PhamVietDan/Micromouse-Maze-solving-robot/wheelsV2.STL

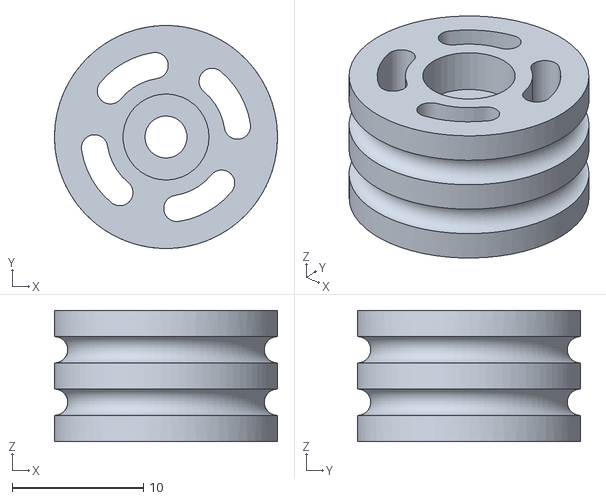
[picture p33: CAD file, 2026-02-28]
wheelsV2.STL
17.0 x 17.0 x 10.0
