PhamVietDan/Micromouse-Maze-solving-robot/GASV1.STL

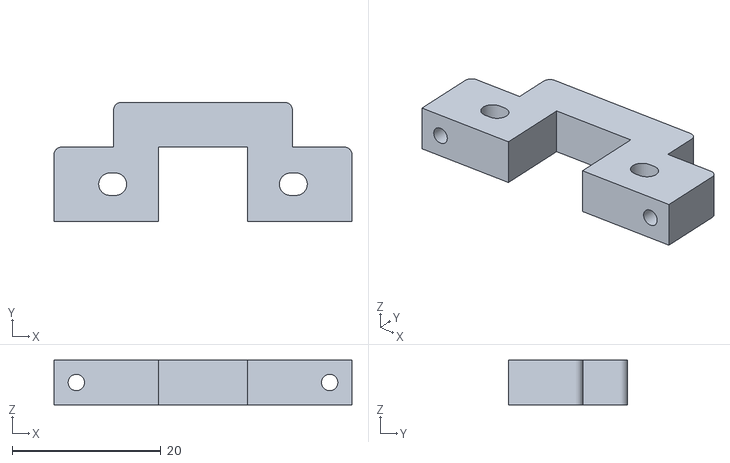
[picture p34: CAD file, 2026-02-28]
GASV1.STL
40.0 x 16.0 x 6.00
