PhamVietDan/Micromouse-Maze-solving-robot/GASV2.STL

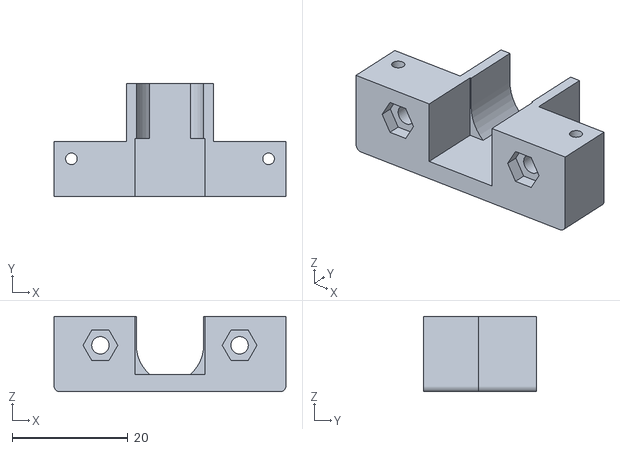
[picture p35: CAD file, 2026-02-28]
GASV2.STL
40.0 x 19.5 x 13.0
