PhamVietDan/Micromouse-Maze-solving-robot/wheelsV1.STL

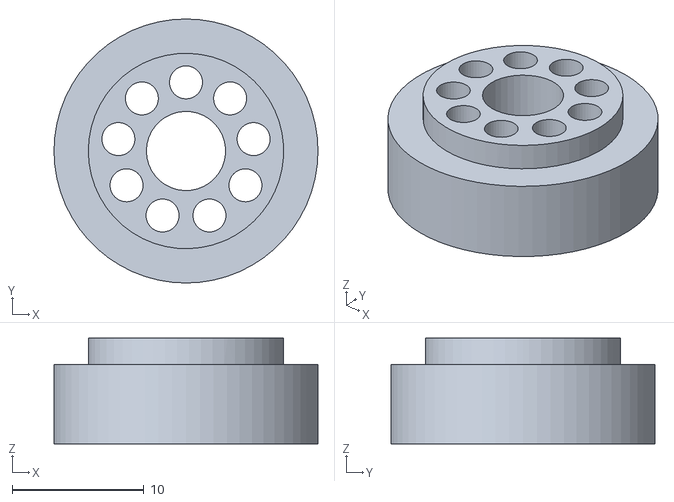
[picture p36: CAD file, 2026-02-28, an earlier design]
wheelsV1.STL
20.0 x 20.0 x 8.00
