PhamVietDan/Micromouse-Maze-solving-robot/Sơ đồ chính_3sodochinh.pdf

# Micromouse

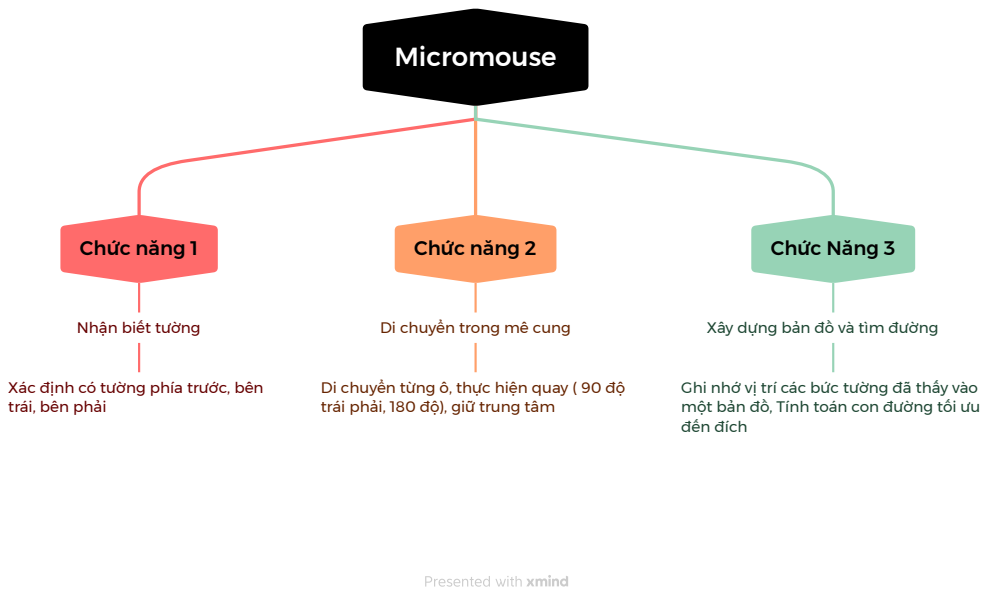
[picture p37: page 1]
Chức năng 1; Chức năng 2; Chức Năng 3

Nhận biết tường

Di chuyển trong mê cung

Xây dựng bản đồ và tìm đường

Xác định có tường phía trước, bên
trái, bên phải

Di chuyển từng ô, thực hiện quay ( 90 độ
trái phải, 180 độ), giữ trung tâm

Ghi nhớ vị trí các bức tường đã thấy vào
một bản đồ, Tính toán con đường tối ưu
đến đích

# Tích hợp phần cứng

## IR trước (1)

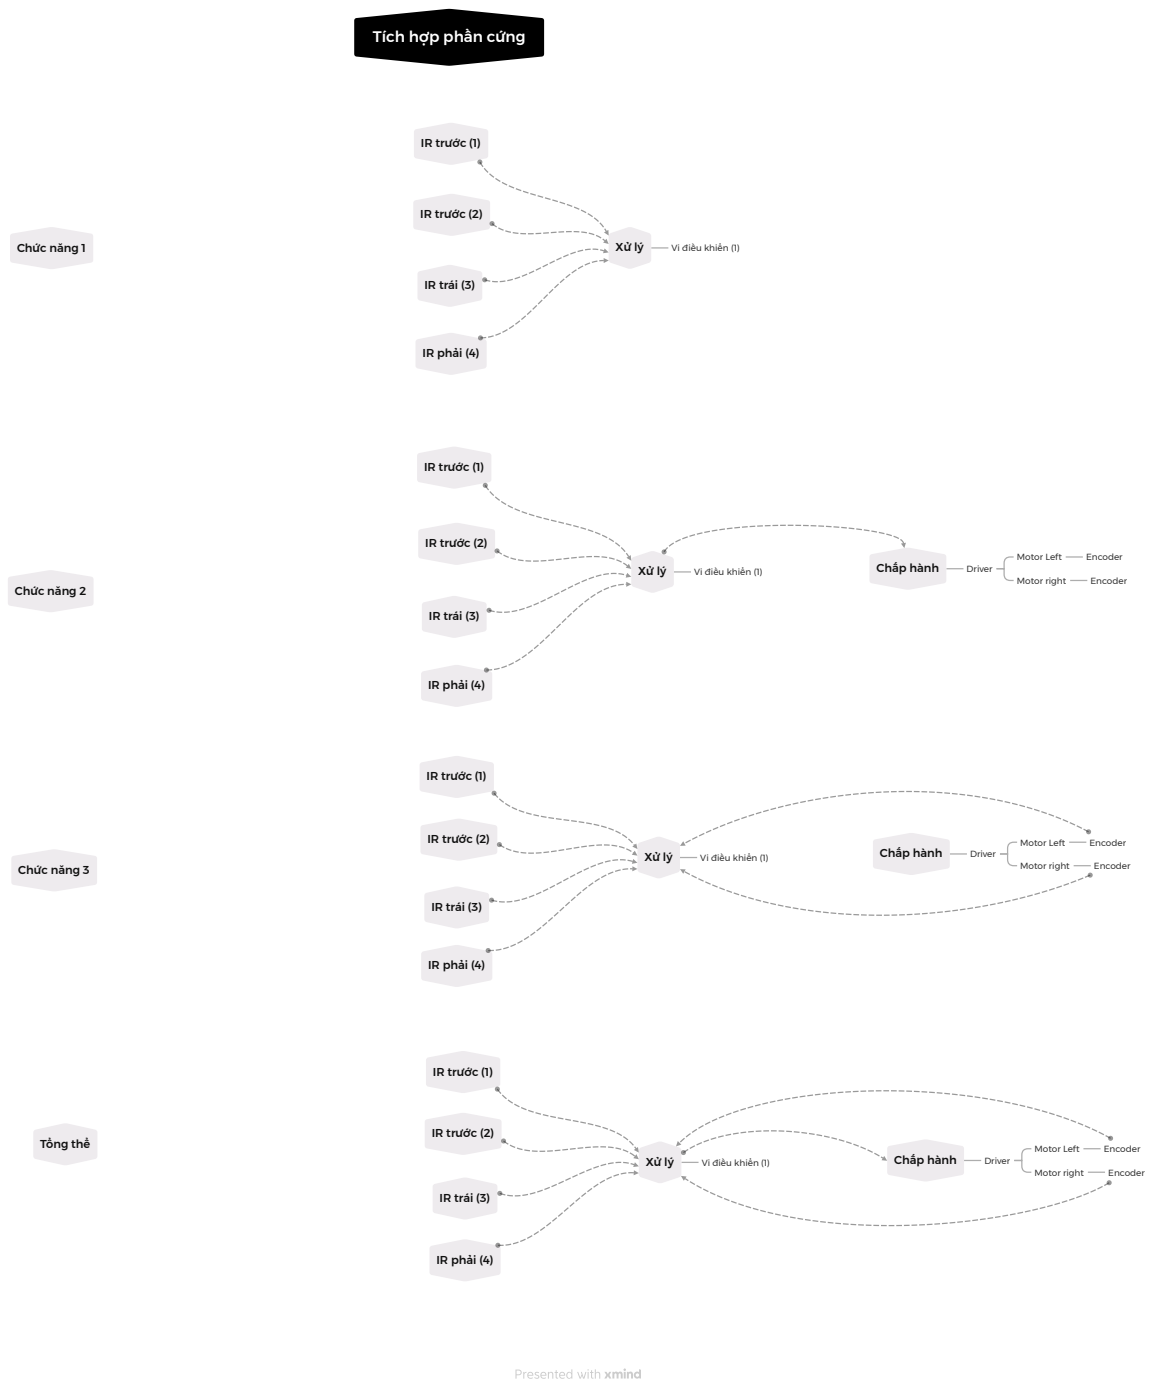
[picture p38: page 2]
IR trước (2); IR phải (4); IR trái (3); Chức năng 1; Vi điều khiển (1); Chức năng 2; IR trước (1); Chấp hành; Driver; Motor Left; Encoder; Motor right; Chức năng 3; Tổng thể

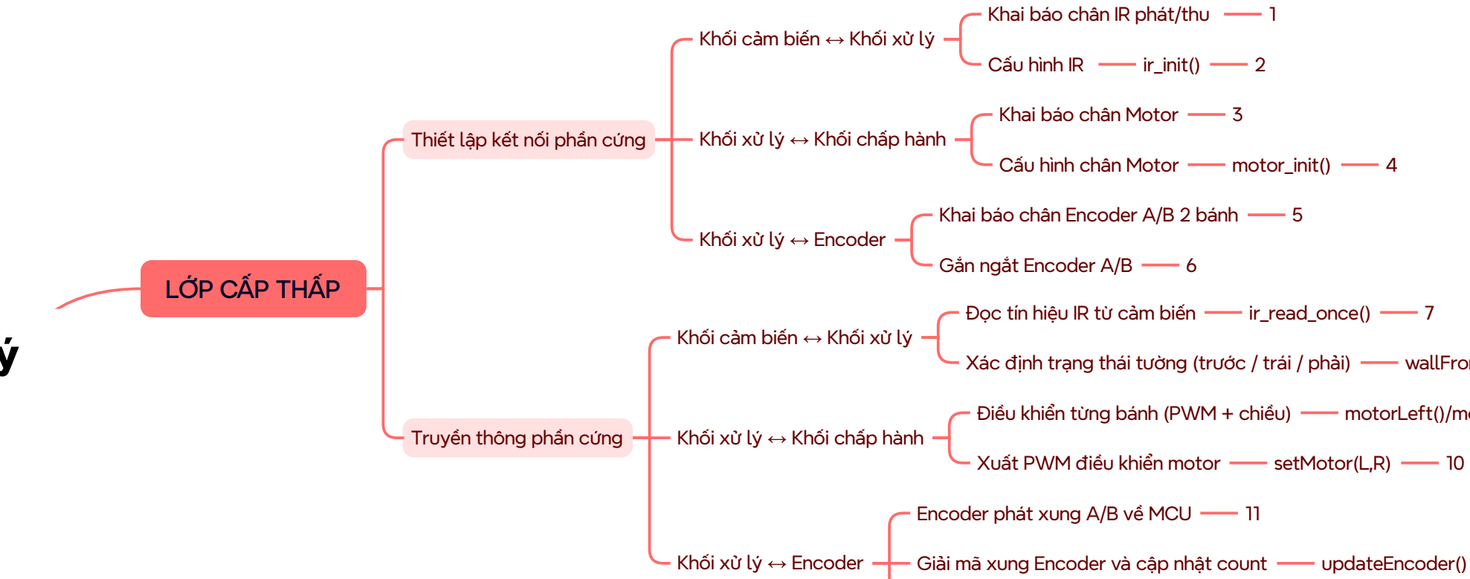
[picture p39: figure]
LỚP CẤP THẤP; Thiết lập kết nối phần cứng; Khai báo chân IR phát/thu; Cấu hình IR; ir_init(); Khối xử lý ↔ Khối chấp hành; Khai báo chân Motor; Cấu hình chân Motor; motor_init(); Khối xử lý ↔ Encoder; Khai báo chân Encoder A/B 2 bánh; Gắn ngắt Encoder A/B; Truyền thông phần cứng; Khối cảm biến ↔ Khối xử lý; Xuất PWM điều khiển motor; setMotor(L,R); Encoder phát xung A/B về MCU
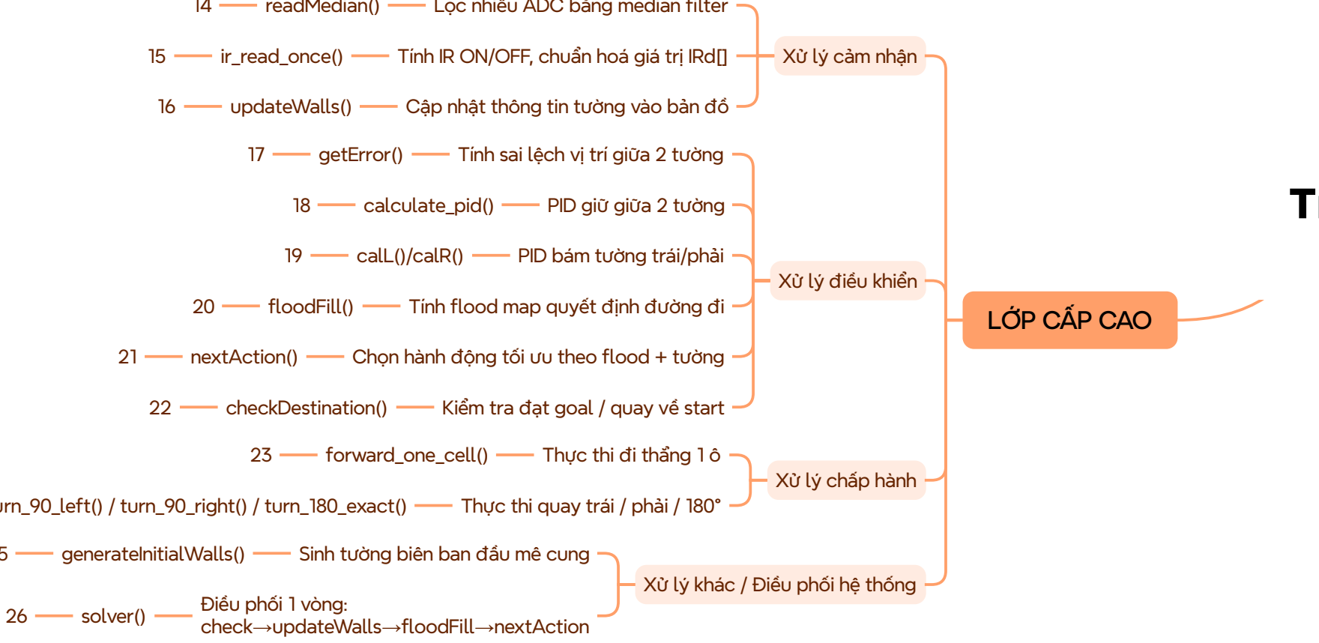
[picture p40: figure]
LỚP CẤP CAO; Xử lý cảm nhận; Xử lý điều khiển; calculate_pid(); PID giữ giữa 2 tường; calL()/calR(); PID bám tường trái/phải; Xử lý chấp hành; Xử lý khác / Điều phối hệ thống; Điều phối 1 vòng:; check→updateWalls→floodFill→nextAction 26; solver()

# Tích hợp xử lý thông tin

Khối cảm biến ↔ Khối xử lý

Đọc tín hiệu IR từ cảm biến | ir_read_once() | 7
Xác định trạng thái tường (trước / trái / phải) | wallFront() / wallLeft() / wallRight() | 8
Điều khiển từng bánh (PWM + chiều) | motorLeft()/motorRight() | 9
Giải mã xung Encoder và cập nhật count | updateEncoder() | 12
Reset encoder trước chu kỳ di chuyển | resetEncoder() | 13
14 | readMedian() | Lọc nhiễu ADC bằng median filter
15 | ir_read_once() | Tính IR ON/OFF, chuẩn hoá giá trị IRd[]
16 | updateWalls() | Cập nhật thông tin tường vào bản đồ
17 | getError() | Tính sai lệch vị trí giữa 2 tường
20 | floodFill() | Tính flood map quyết định đường đi
21 | nextAction() | Chọn hành động tối ưu theo flood + tường
22 | checkDestination() | Kiểm tra đạt goal / quay về start
23 | forward_one_cell() | Thực thi đi thẳng 1 ô
24 | turn_90_left() / turn_90_right() / turn_180_exact() | Thực thi quay trái / phải / 180°
25 | generateInitialWalls() | Sinh tường biên ban đầu mê cung
