PhamVietDan/Micromouse-Maze-solving-robot/schematic.pdf

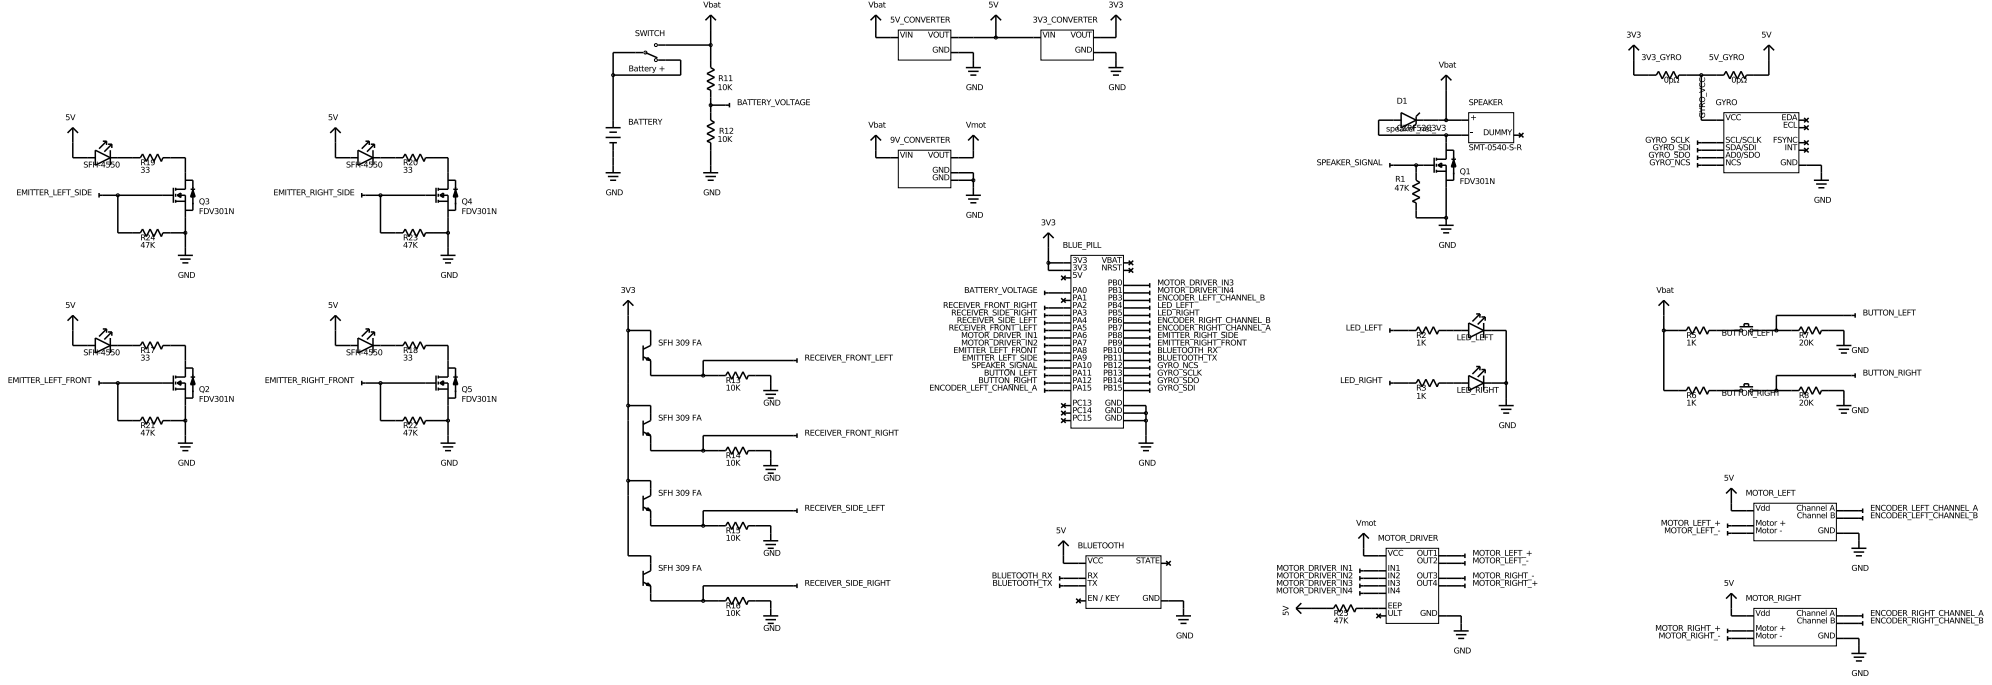
[picture p41: page 1]
