PhamVietDan/Micromouse-Maze-solving-robot/Sơ đồ mở rộng_sodo4_thuattoan.pdf

# Bắt đầu

# Khởi tạo cảm biến hồng ngoại

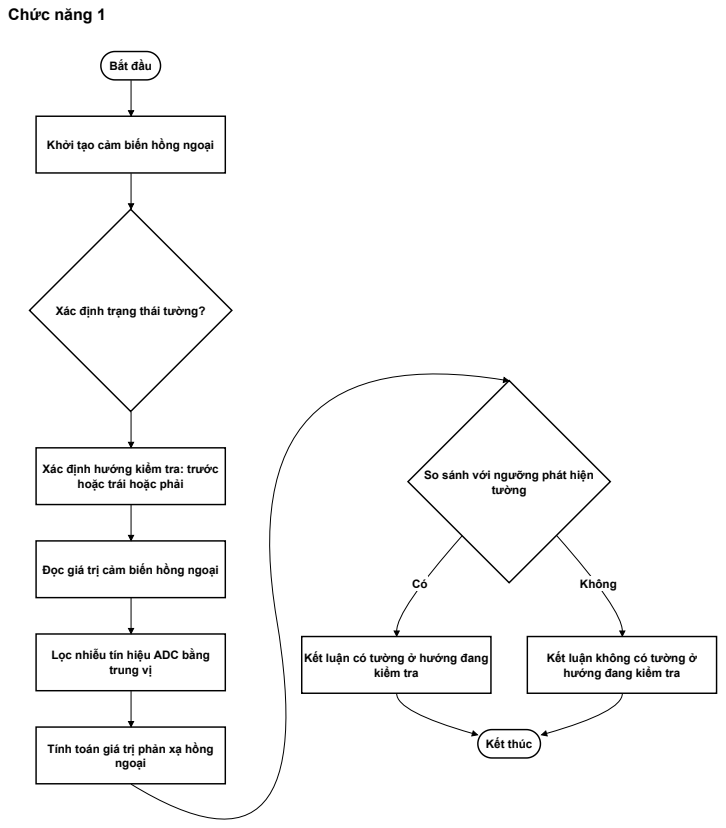
[picture p42: page 1]
trung vị; ngoại; tường; kiểm tra; Kết thúc; Không; Chức năng 1

Xác định trạng thái tường?

Xác định hướng kiểm tra: trước
hoặc trái hoặc phải

So sánh với ngưỡng phát hiện

Đọc giá trị cảm biến hồng ngoại

Lọc nhiễu tín hiệu ADC bằng

Kết luận có tường ở hướng đang

Kết luận không có tường ở
hướng đang kiểm tra

Tính toán giá trị phản xạ hồng

# Bắt đầu

# Nhận lệnh di chuyển sang ô

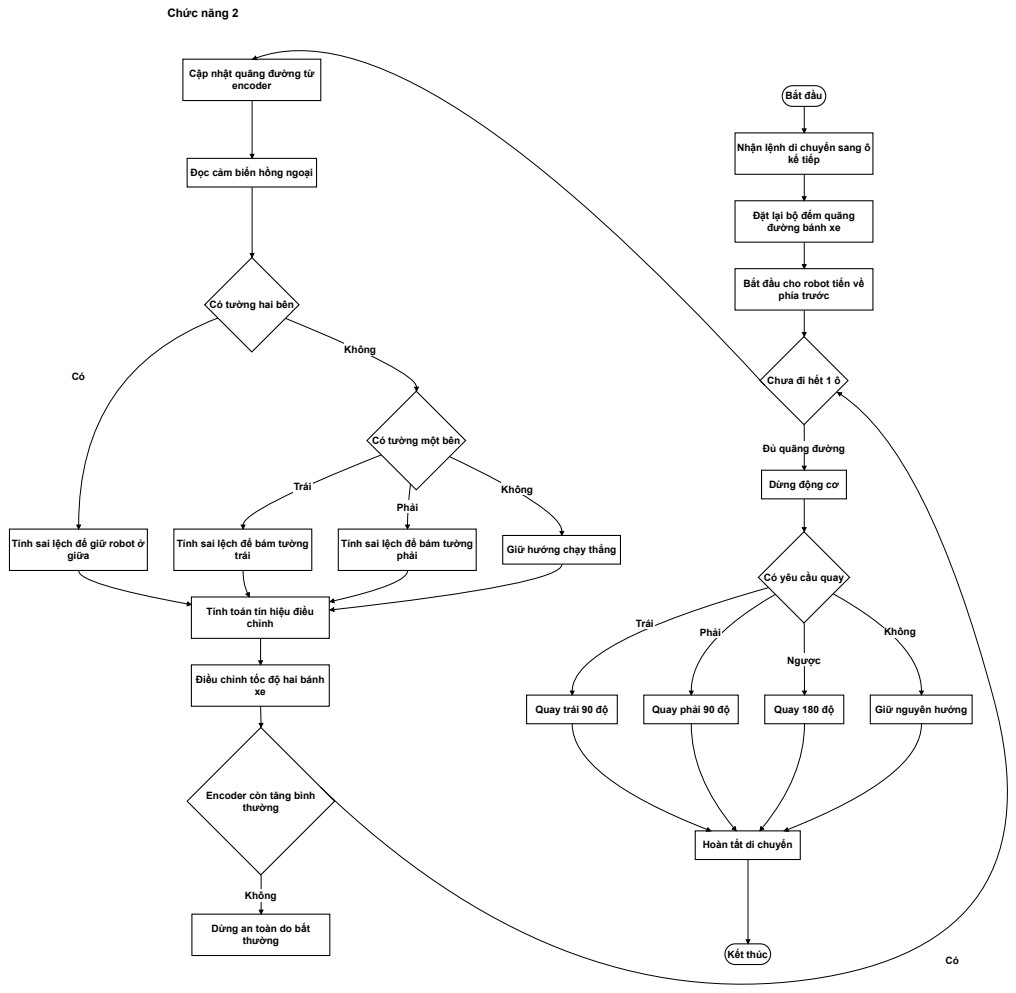
[picture p43: page 2]
kế tiếp; encoder; giữa; trái; Tính sai lệch để bám tường; phải; Giữ hướng chạy thẳng; chỉnh; thường; Quay trái 90 độ; Quay phải 90 độ; Quay 180 độ; Giữ nguyên hướng; Kết thúc; Không; Trái; Phải; Ngược; Chức năng 2

Cập nhật quãng đường từ

Đọc cảm biến hồng ngoại

Đặt lại bộ đếm quãng
đường bánh xe

Bắt đầu cho robot tiến về phía trước

Có tường hai bên

Chưa đi hết 1 ô

Có tường một bên

Đủ quãng đường

Dừng động cơ

Tính sai lệch để giữ robot ở

Tính sai lệch để bám tường

Có yêu cầu quay

Tính toán tín hiệu điều

Điều chỉnh tốc độ hai bánh

Encoder còn tăng bình

Hoàn tất di chuyển

Dừng an toàn do bất
thường

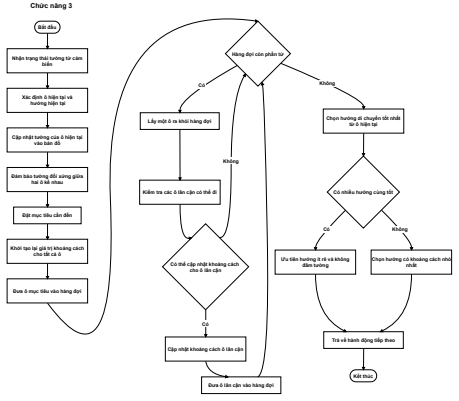
[picture p44: figure]
Bắt đầu; Nhận trạng thái tường từ cảm biến; Xác định ô hiện tại và hướng hiện tại; Đặt mục tiêu cần đến; Khởi tạo lại giá trị khoảng cách cho tất cả ô; Đưa ô mục tiêu vào hàng đợi; Hàng đợi còn phần tử; Lấy một ô ra khỏi hàng đợi; Kiểm tra các ô lân cận có thể đi; Có thể cập nhật khoảng cách cho ô lân cận; Cập nhật khoảng cách ô lân cận; Đưa ô lân cận vào hàng đợi; Chọn hướng di chuyển tốt nhất từ ô hiện tại; Có nhiều hướng cùng tốt; Ưu tiên hướng ít rẽ và không; đâm tường; Chọn hướng có khoảng cách nhỏ; nhất; Trả về hành động tiếp theo; Kết thúc; Không

Cập nhật tường của ô hiện tại vào bản đồ

Đảm bảo tường đối xứng giữa hai ô kề nhau

## Chức năng 3

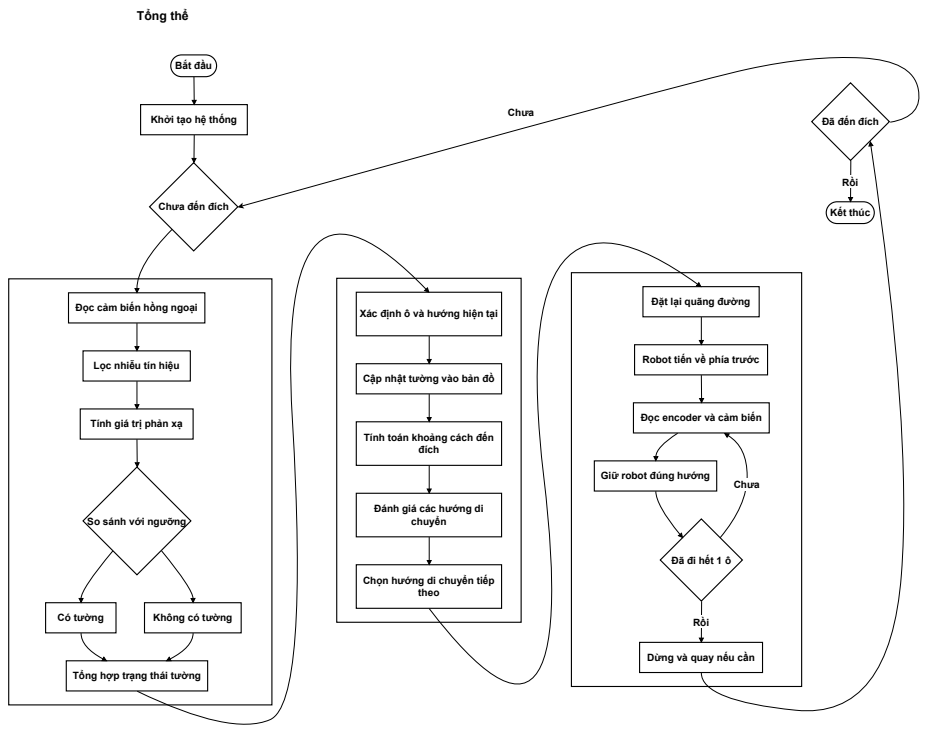
[picture p45: page 4]
Có tường; Không có tường; theo; Kết thúc; Chưa; Rồi; Tổng thể

Bắt đầu Khởi tạo hệ thống

Đã đến đích

Chưa đến đích

Đọc cảm biến hồng ngoại Lọc nhiễu tín hiệu

Xác định ô và hướng hiện tại Cập nhật tường vào bản đồ

Đặt lại quãng đường Robot tiến về phía trước Đọc encoder và cảm biến Giữ robot đúng hướng

Tính giá trị phản xạ

Tính toán khoảng cách đến
đích Đánh giá các hướng di chuyển Chọn hướng di chuyển tiếp

So sánh với ngưỡng

Đã đi hết 1 ô

Tổng hợp trạng thái tường

Dừng và quay nếu cần
