PhamVietDan/Micromouse-Maze-solving-robot/(list of files, drawings)

Other design files:
MICROMOUSE.PcbDoc
MICROMOUSE.SchDoc
