PhamVietDan/Micromouse-Maze-solving-robot/(commit log)

2026-02-28 first init
    [GASV1.STL, GASV2.STL, wheelsV1.STL, wheelsV2.STL]
2026-03-02 core hall init
